cchaine/UMXdbg/README.md

# UMXdbg
A Hardware Debugger board to test UMXbus modules independently
