cchaine/UMXdbg/docs/debug-Power.pdf

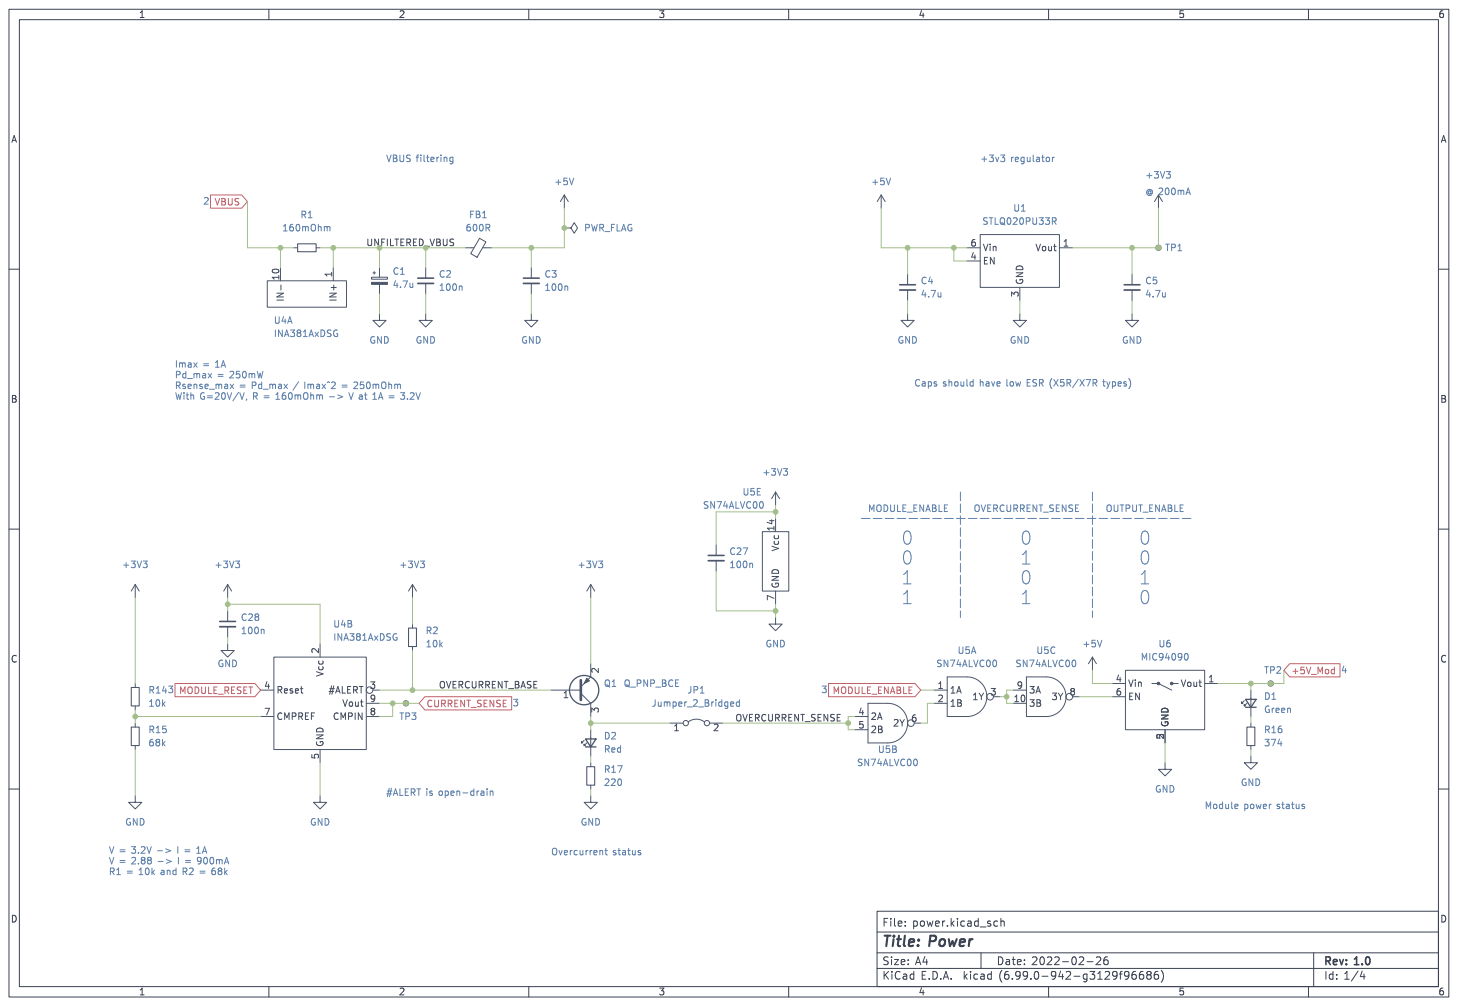
[picture p1: page 1]

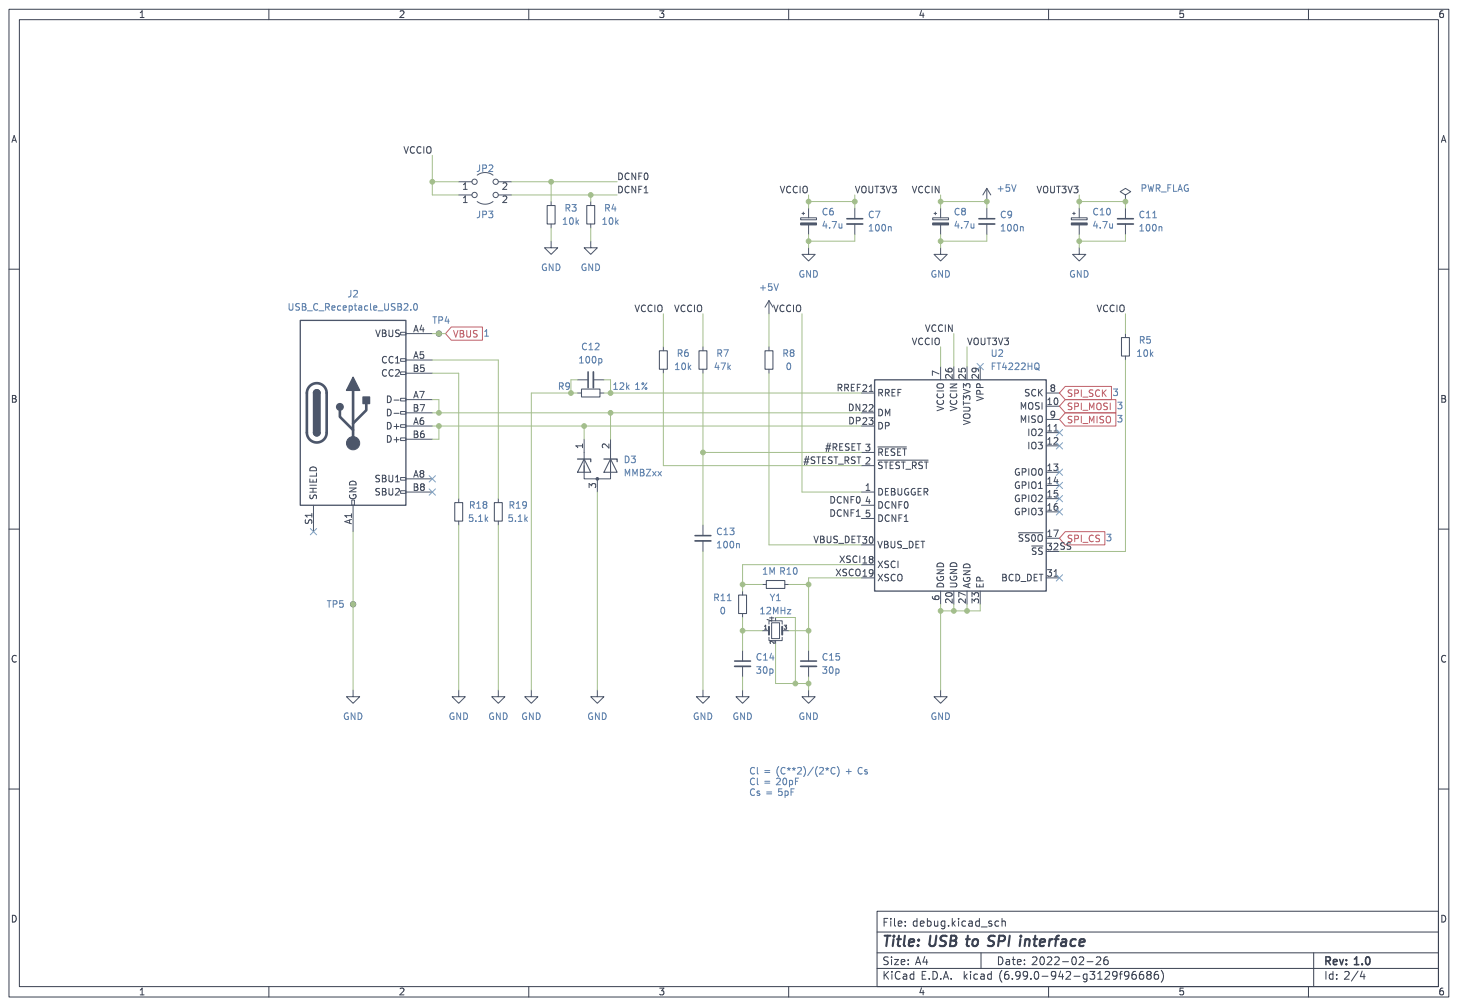
[picture p2: page 2]

File: debug.kicad_sch Bus connector File: schematics/bus.kicad_sch MCU

Id: 2/4 Title: USB to SPI interface

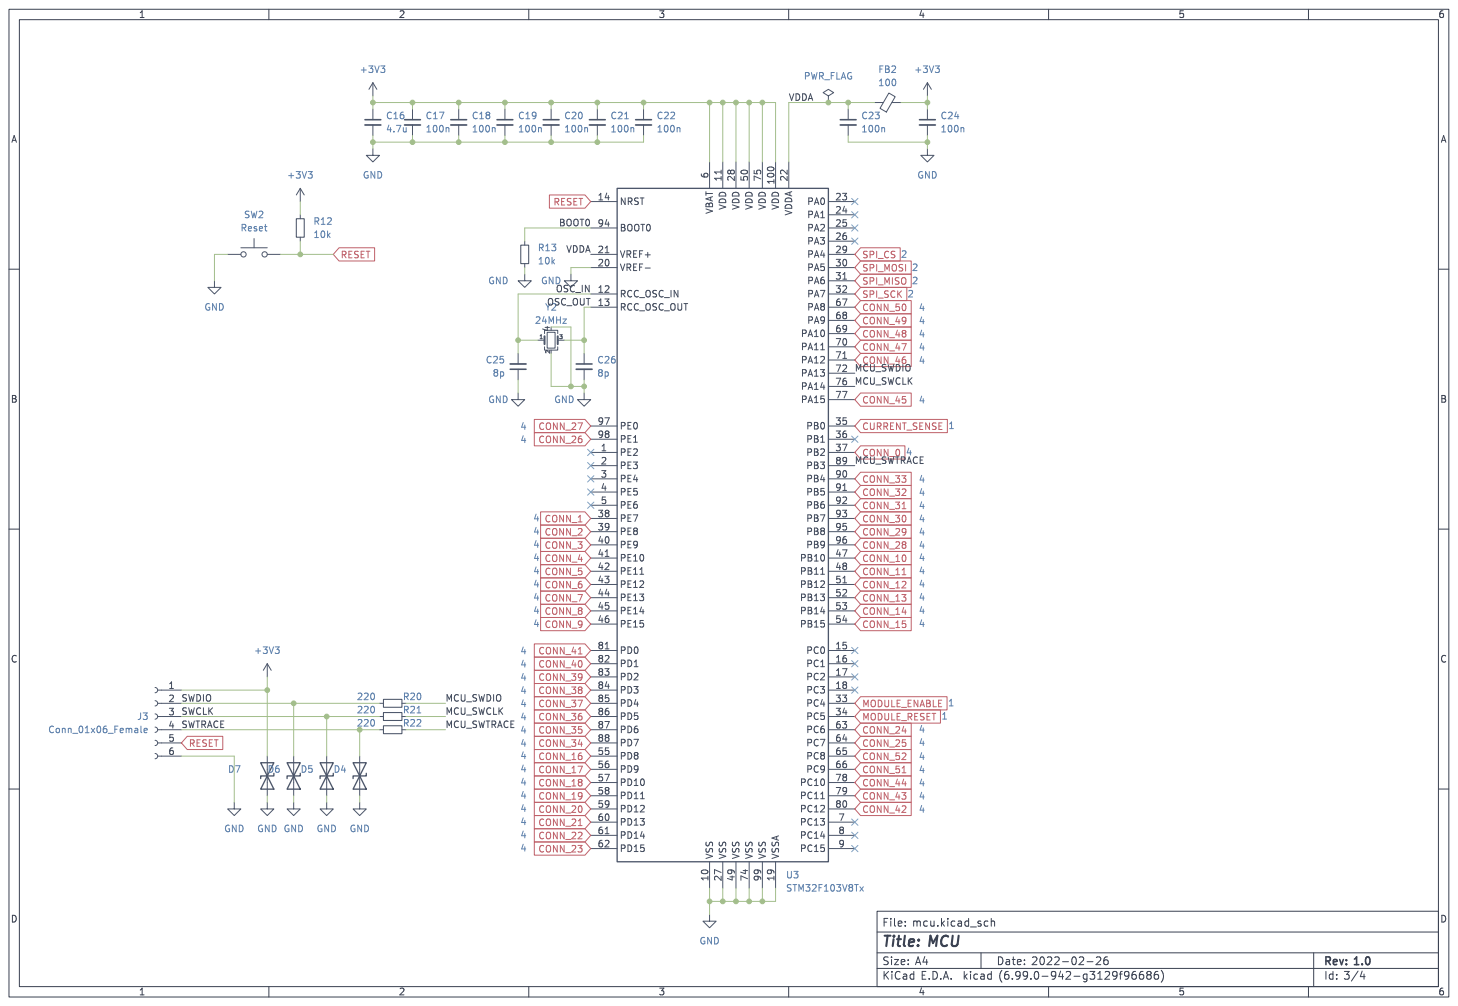
[picture p3: page 3]

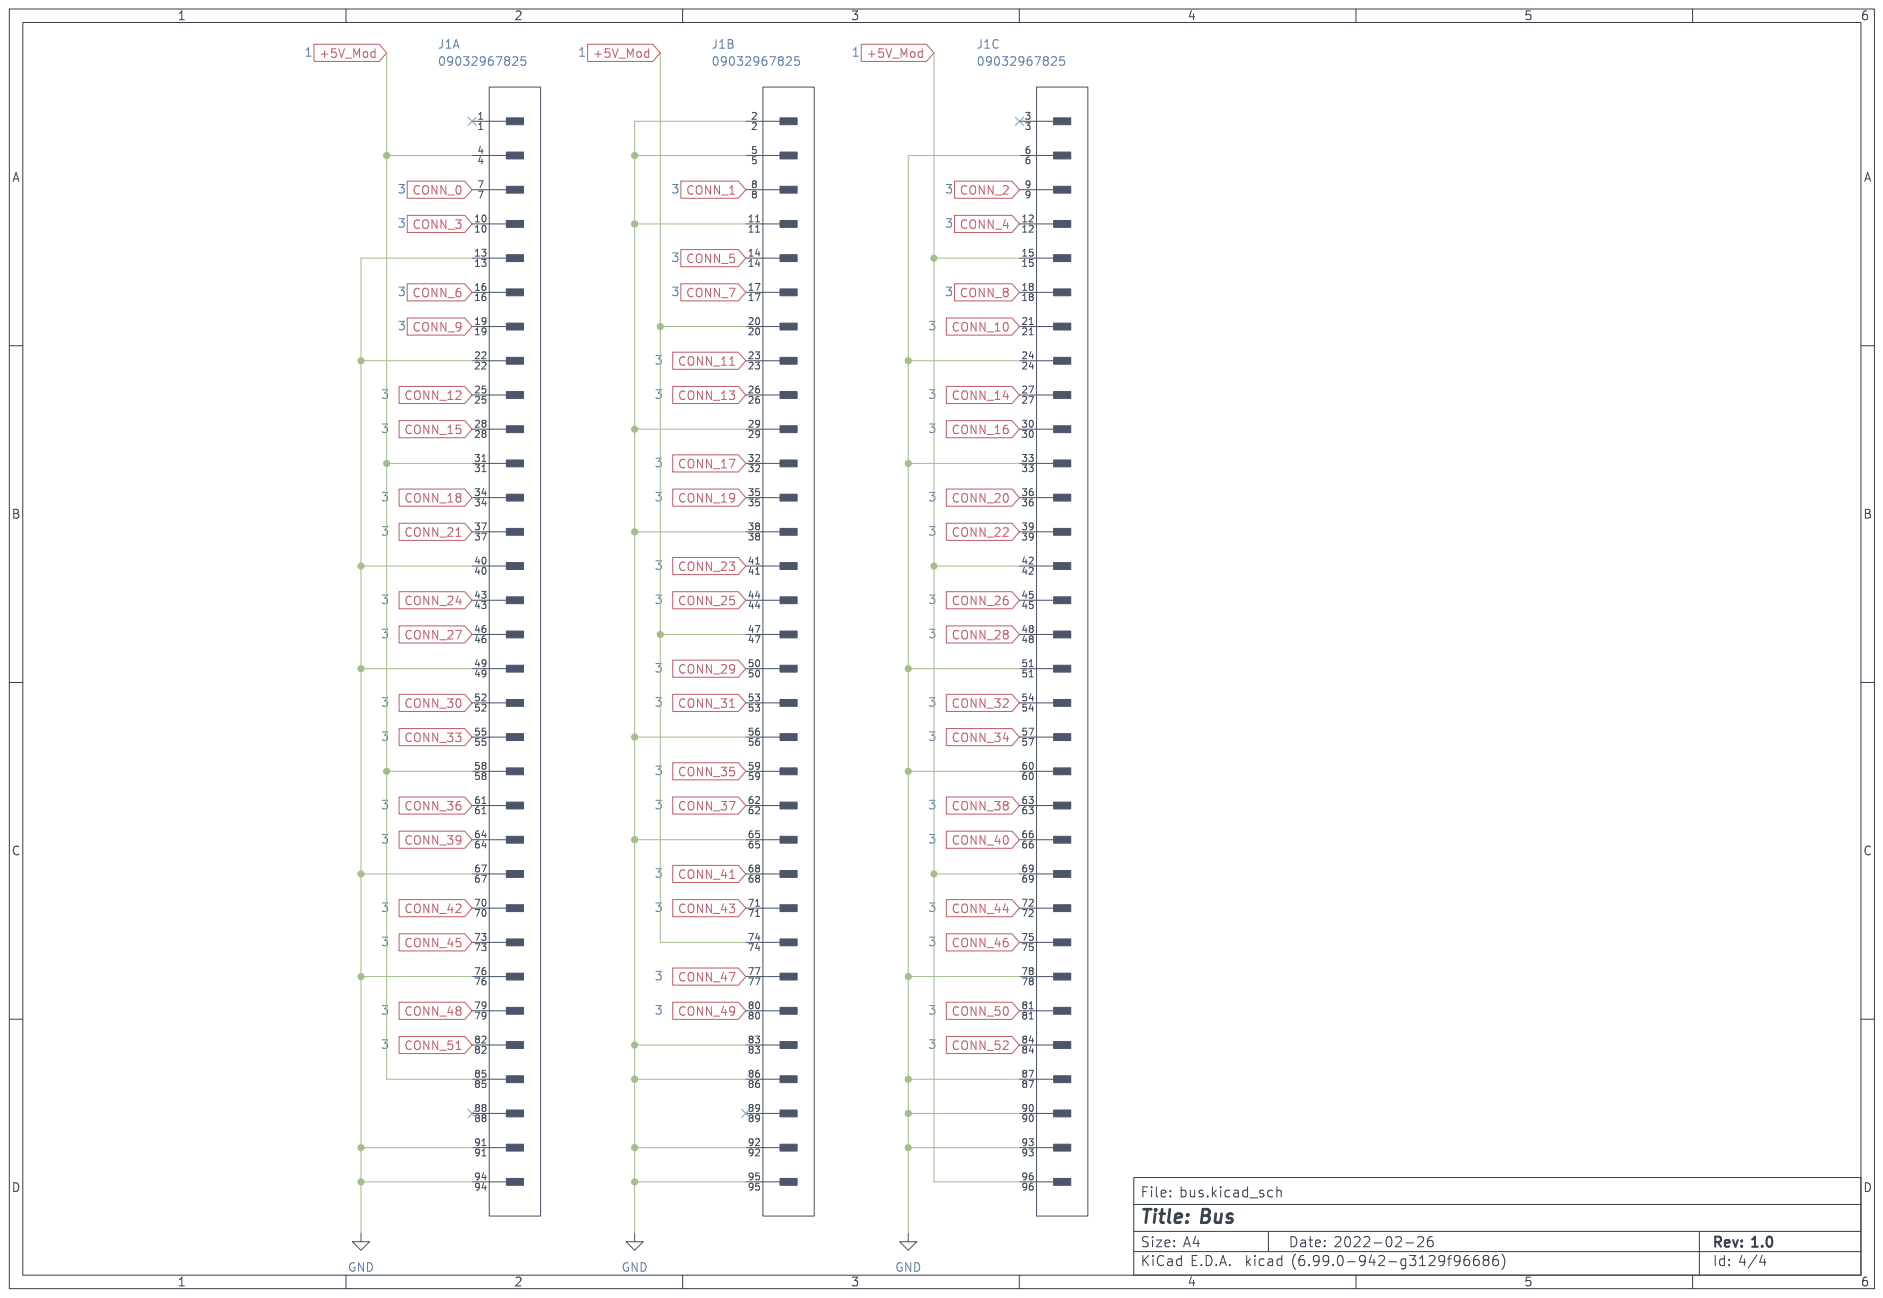
[picture p4: page 4]
