cchaine/UMXdbg/pcb/debug.kicad_pcb

## KiCad design pcb/debug.kicad_pcb (2022-02-19)

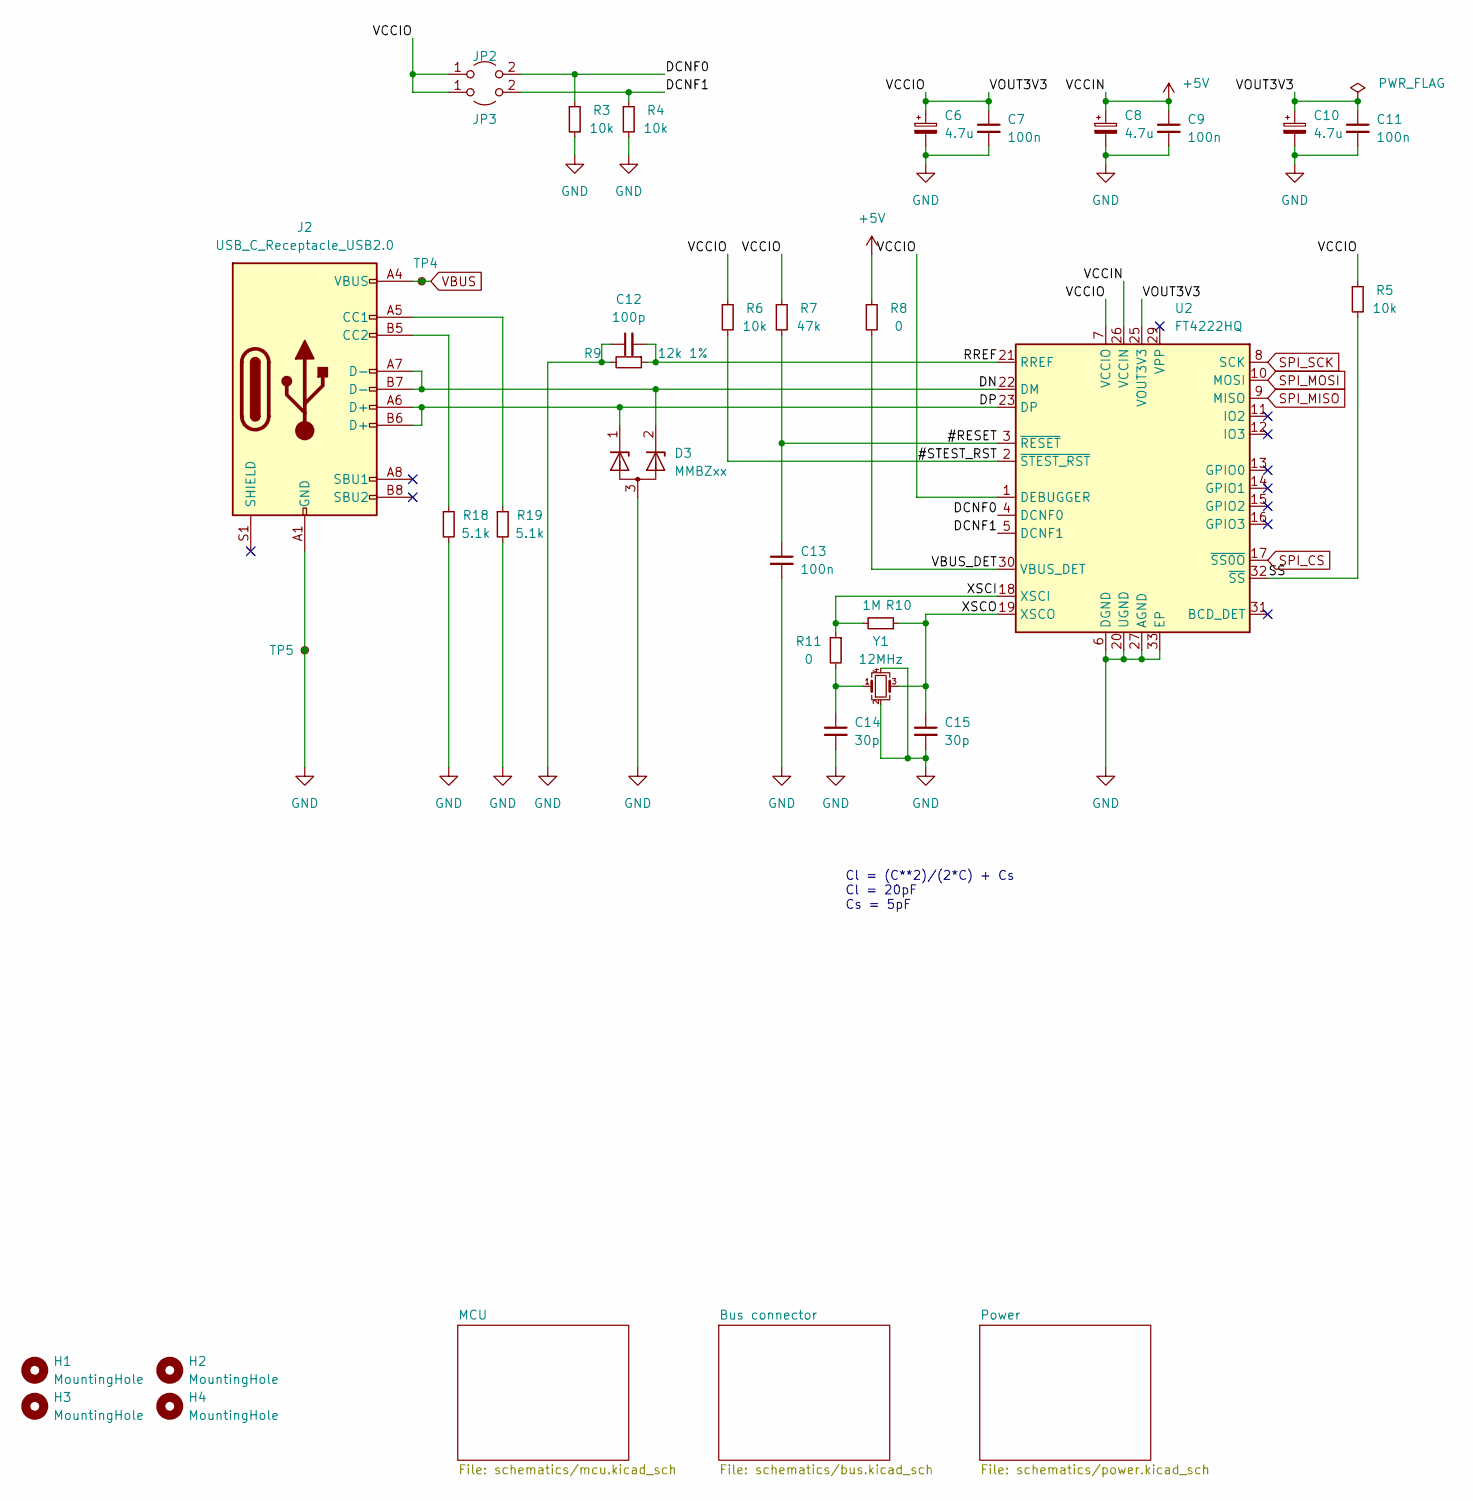
[picture p5: schematic debug.kicad_sch, USB to SPI interface]

Parts:
C6, C8, C10: 4.7u; C_0805_2012Metric; Part Number GRM21BR71C475KE51L
C7, C9, C11, C13: 100n; C_0603_1608Metric; Part Number 885012206095
C12: 100p; C_0603_1608Metric; Part Number 06035A101JAT4A
C14, C15: 30p; C_0603_1608Metric; Part Number C0603C300K1HACTU
D3: MMBZxx; SOT-23; Part Number MMBZ5V6ALFHT116
H1, H2, H3, H4: MountingHole; MountingHole_2.7mm_M2.5
J2: USB_C_Receptacle_USB2.0; GCT_USB4105-GF-A; Part Number USB4105-GF-A
JP2, JP3: Jumper_2_Open; SolderJumper-2_P1.3mm_Open_RoundedPad1.0x1.5mm
R3, R4, R5, R6: 10k; R_0603_1608Metric; Part Number CR0603-FX-1002ELF
R7: 47k; R_0603_1608Metric; Part Number AC0603FR-0747KL
R8, R11: 0; R_0603_1608Metric; Part Number CR0603-J/-000ELF
R9: 12k 1%; R_0603_1608Metric; Part Number RC0603FR-1012KL
R10: 1M; R_0603_1608Metric; Part Number CR0603-FX-1004ELF
R18, R19: 5.1k; R_0603_1608Metric; Part Number CR0603-FX-5101ELF
TP4, TP5: TestPoint_Small; TestPoint_Loop_D2.54mm_Drill1.5mm_Beaded
U2: FT4222HQ; VQFN-32-1EP_5x5mm_P0.5mm_EP3.1x3.1mm; Part Number FT4222HQ-D-R
Y1: 12MHz; XTAL_ECS-120-18-33-JGN-TR; Part Number ECS-120-18-33-JGN-TR3

Connections:
+5V: C8.1, C9.1, R8.1, U2.26 (VCCIN); also elsewhere on the board
/#RESET: C13.1, R7.2, U2.3 (~RESET)
/#STEST_RST: R6.2, U2.2 (~STEST_RST)
/DCNF0: JP2.2 (B), R3.1, U2.4 (DCNF0)
/DCNF1: JP3.2 (B), R4.1, U2.5 (DCNF1)
/DN: D3.2 (K), J2.A7 (D-), J2.B7 (D-), U2.22 (DM)
/DP: D3.1 (K), J2.A6 (D+), J2.B6 (D+), U2.23 (DP)
/RREF: C12.2, R9.1, U2.21 (RREF)
/SS: R5.2, U2.32 (~SS)
/VBUS_DET: R8.2, U2.30 (VBUS_DET)
/VCCIO: C6.1, C7.1, C10.1, C11.1, JP2.1 (A), JP3.1 (A), R5.1, R6.1, R7.1, U2.1 (DEBUGGER), U2.7 (VCCIO), U2.25 (VOUT3V3)
/XSCI: R10.2, R11.1, U2.18 (XSCI)
/XSCO: C15.1, R10.1, U2.19 (XSCO), Y1.3
GND: C6.2, C7.2, C8.2, C9.2, C10.2, C11.2, C12.1, C13.2, C14.2, C15.2, D3.3 (A), J2.A1 (GND), J2.A12 (GND), J2.B1 (GND), J2.B12 (GND), R3.2, R4.2, R9.2, R18.2, R19.2, TP5.1, U2.6 (DGND), U2.20 (UGND), U2.24 (UGND), U2.27 (AGND), U2.28 (DGND), U2.33 (EP), Y1.2, Y1.4; also elsewhere on the board
unnamed: C14.1, R11.2, Y1.1
unnamed: J2.A5 (CC1), R19.1
unnamed: J2.B5 (CC2), R18.1
SPI_CS: U2.17 (~SS0O); also elsewhere on the board
SPI_MISO: U2.9 (MISO); also elsewhere on the board
SPI_MOSI: U2.10 (MOSI); also elsewhere on the board
SPI_SCK: U2.8 (SCK); also elsewhere on the board
VBUS: J2.A4 (VBUS), J2.A9 (VBUS), J2.B4 (VBUS), J2.B9 (VBUS), TP4.1; also elsewhere on the board

Notes on the sheet:
Cl = (C**2)/(2*C) + Cs Cl = 20pF Cs = 5pF

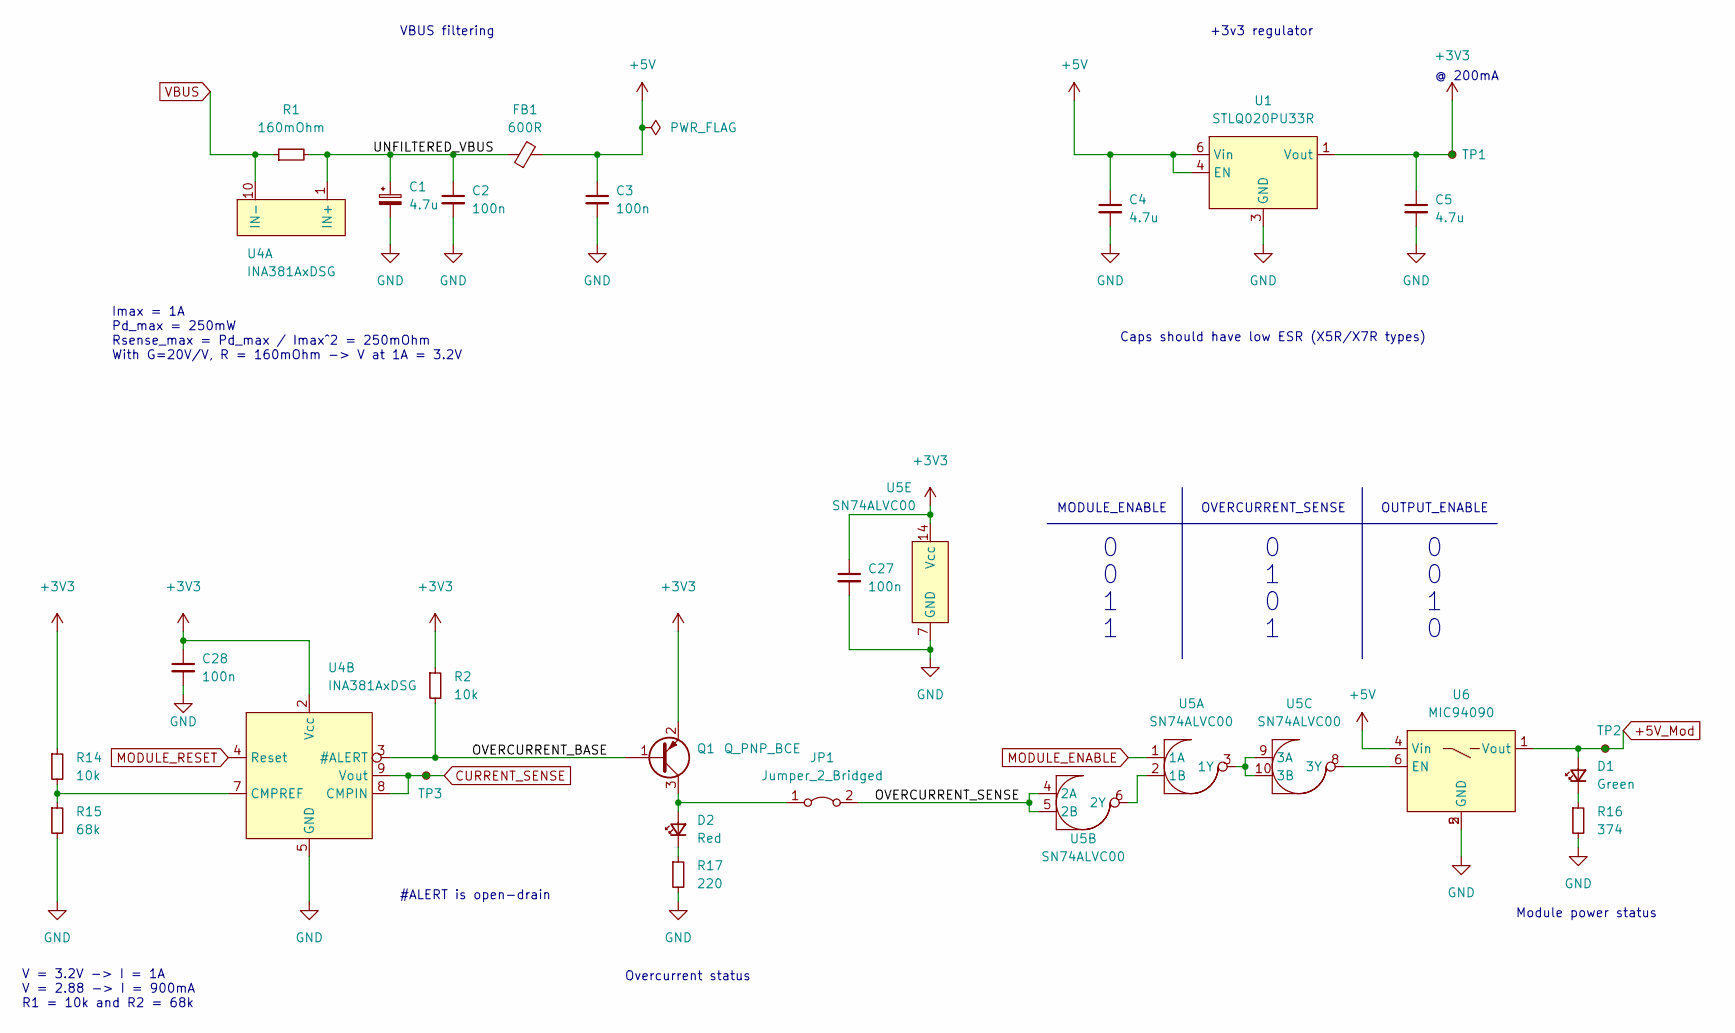
[picture p6: schematic power.kicad_sch]

Parts:
C1, C4, C5: 4.7u; C_0805_2012Metric; Part Number GRM21BR71C475KE51L
C2, C3, C27, C28: 100n; C_0603_1608Metric; Part Number 885012206095
D1: Green; LED_1206_3216Metric; Part Number 156120VS75300
D2: Red; LED_1206_3216Metric; Part Number 156120RS75300
FB1: 600R; L_1206_3216Metric; Part Number MH3261-601Y
JP1: Jumper_2_Bridged; SolderJumper-2_P1.3mm_Bridged_RoundedPad1.0x1.5mm
Q1: Q_PNP_BCE; SOT-23; Part Number BC857,215
R1: 160mOhm; R_0805_2012Metric; Part Number RL1220S-R16-F
R2, R14: 10k; R_0603_1608Metric; Part Number CR0603-FX-1002ELF
R15: 68k; R_0603_1608Metric; Part Number CR0603-FX-6802ELF
R16: 374; R_0603_1608Metric; Part Number CR0603-FX-3740ELF
R17: 220; R_0603_1608Metric; Part Number RC0603FR-07220RL
TP1, TP2, TP3: TestPoint_Small; TestPoint_Loop_D2.54mm_Drill1.5mm_Beaded
U1: STLQ020PU33R; DFN-6-1EP_2x2mm_P0.5mm_EP0.6x1.37mm; Part Number STLQ020PU33R
U4: INA381AxDSG; VSSOP-10_3x3mm_P0.5mm; Part Number INA381A1IDGSR
U5: SN74ALVC00; TSSOP-14_4.4x5mm_P0.65mm; Part Number SN74ALVC00PWR
U6: MIC94090; SOT-363_SC-70-6; Part Number MIC94090YC6-TR

Connections:
+3V3: C5.1, C27.1, C28.1, Q1.2 (E), R2.1, R14.1, TP1.1, U1.1 (Vout), U4.2 (Vcc), U5.14 (Vcc); also elsewhere on the board
+5V: C3.1, C4.1, FB1.2, U1.4 (EN), U1.6 (Vin), U6.4 (Vin); also elsewhere on the board
+5V_Mod: D1.2 (A), TP2.1, U6.1 (Vout); also elsewhere on the board
/Power/OVERCURRENT_BASE: Q1.1 (B), R2.2, U4.3 (#ALERT)
/Power/OVERCURRENT_SENSE: JP1.2 (B), U5.4 (2A), U5.5 (2B)
/Power/UNFILTERED_VBUS: C1.1, C2.1, FB1.1, R1.2, U4.1 (IN+)
CURRENT_SENSE: TP3.1, U4.8 (CMPIN), U4.9 (Vout); also elsewhere on the board
GND: C1.2, C2.2, C3.2, C4.2, C5.2, C27.2, C28.2, R15.2, R16.2, R17.2, U1.3 (GND), U4.5 (GND), U5.7 (GND), U6.2 (GND), U6.5 (GND); also elsewhere on the board
MODULE_ENABLE: U5.1 (1A); also elsewhere on the board
MODULE_RESET: U4.4 (Reset); also elsewhere on the board
unnamed: D1.1 (K), R16.1
unnamed: D2.2 (A), JP1.1 (A), Q1.3 (C)
unnamed: D2.1 (K), R17.1
unnamed: R14.2, R15.1, U4.7 (CMPREF)
unnamed: U5.2 (1B), U5.6 (2Y)
unnamed: U5.3 (1Y), U5.9 (3A), U5.10 (3B)
unnamed: U5.8 (3Y), U6.6 (EN)
VBUS: R1.1, U4.10 (IN-); also elsewhere on the board

Notes on the sheet:
OVERCURRENT_SENSE
Module power status
Overcurrent status
@ 200mA
VBUS filtering
V = 3.2V -> I = 1A V = 2.88 -> I = 900mA R1 = 10k and R2 = 68k
Imax = 1A Pd_max = 250mW Rsense_max = Pd_max / Imax^2 = 250mOhm With G=20V/V, R = 160mOhm -> V at 1A = 3.2V
+3v3 regulator
#ALERT is open-drain
OUTPUT_ENABLE
Caps should have low ESR (X5R/X7R types)
MODULE_ENABLE

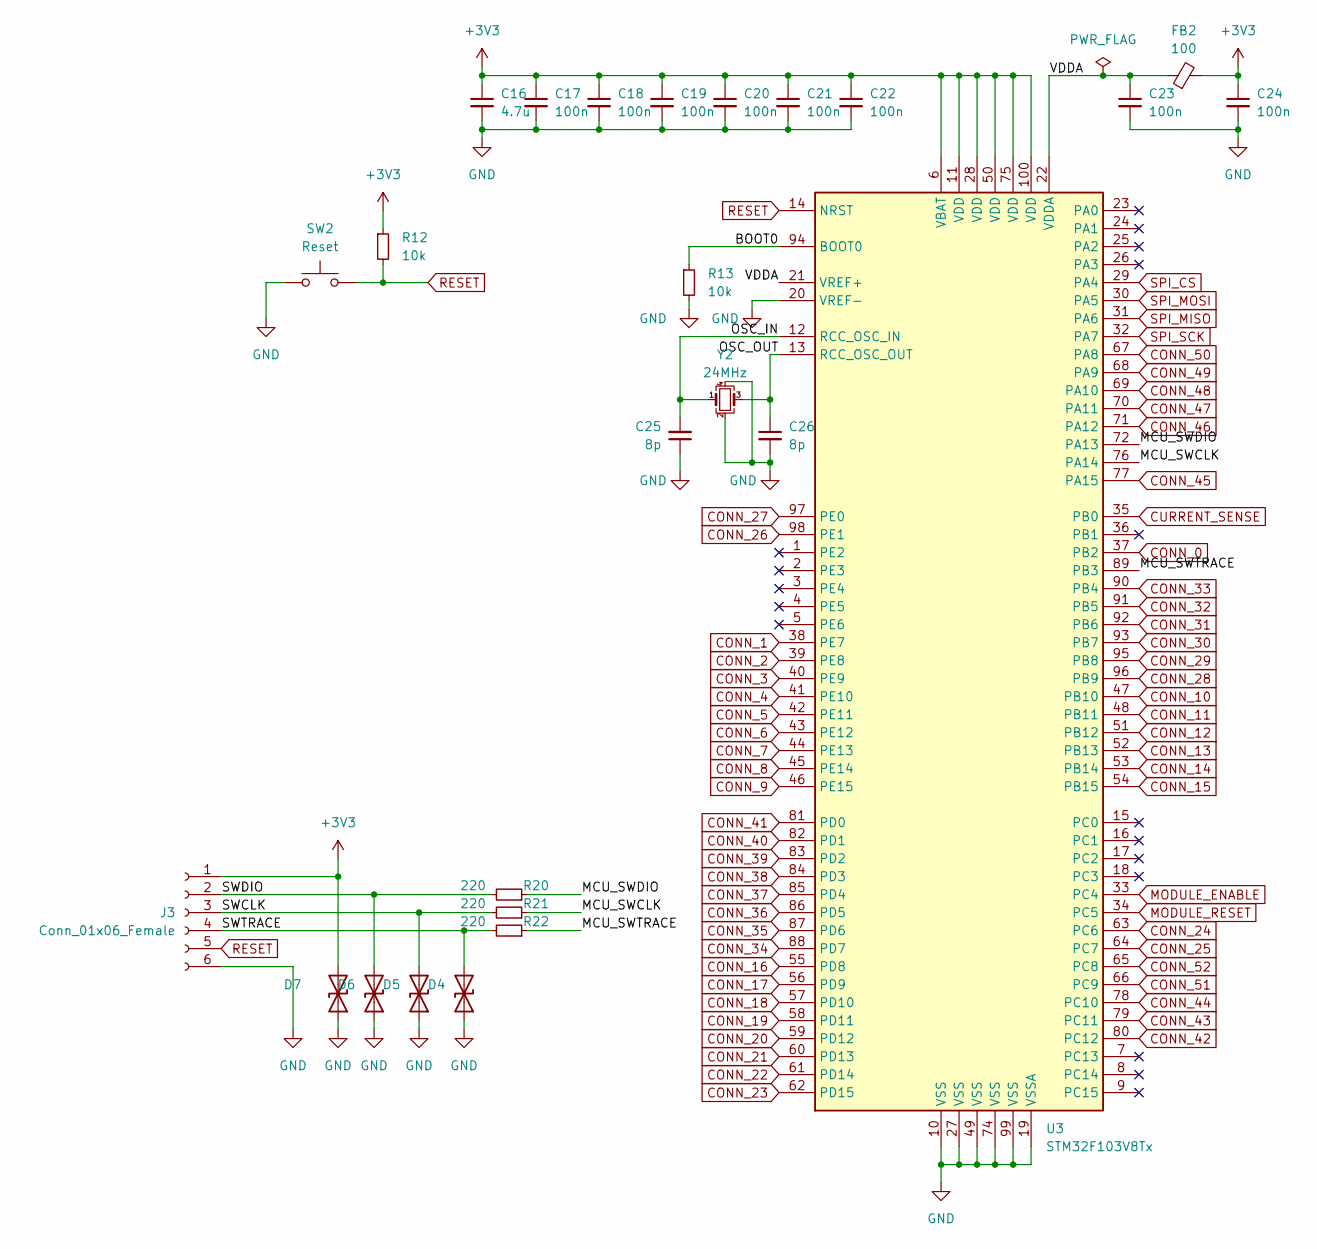
[picture p7: schematic mcu.kicad_sch]

Parts:
C16: 4.7u; C_0805_2012Metric; Part Number GRM21BR71C475KE51L
C17, C18, C19, C20, C21, C22, C23, C24: 100n; C_0603_1608Metric; Part Number 885012206095
C25, C26: 8p; C_0603_1608Metric; Part Number C1608C0G1H080D080AA
D4, D5, D6, D7: D_TVS; TVS_ESD9D5.0ST5G; Part Number DF2S10FS,L3M
FB2: 100; L_0805_2012Metric; Part Number MG2029-101Y
J3: Conn_01x06_Female; PinHeader_1x06_P1.27mm_Vertical
R12, R13: 10k; R_0603_1608Metric; Part Number CR0603-FX-1002ELF
R20, R21, R22: 220; R_0603_1608Metric; Part Number RC0603FR-07220RL
SW2: Reset; Panasonic_EVQPUJ_EVQPUA
U3: STM32F103V8Tx; LQFP-100_14x14mm_P0.5mm; Part Number STM32F103V8Tx
Y2: 24MHz; Crystal_SMD_SeikoEpson_TSX3225-4Pin_3.2x2.5mm; Part Number 732-22524MF15X-AC6

Connections:
+3V3: C16.1, C17.1, C18.1, C19.1, C20.1, C21.1, C22.1, C24.1, D7.2 (A2), FB2.2, J3.1, R12.1, U3.6 (VBAT), U3.11 (VDD), U3.28 (VDD), U3.50 (VDD), U3.75 (VDD), U3.100 (VDD); also elsewhere on the board
/MCU/BOOT0: R13.1, U3.94 (BOOT0)
/MCU/MCU_SWCLK: R21.1, U3.76 (PA14)
/MCU/MCU_SWDIO: R20.1, U3.72 (PA13)
/MCU/MCU_SWTRACE: R22.1, U3.89 (PB3)
/MCU/OSC_IN: C25.2, U3.12 (RCC_OSC_IN), Y2.1
/MCU/OSC_OUT: C26.1, U3.13 (RCC_OSC_OUT), Y2.3
/MCU/SWCLK: D5.2 (A2), J3.3, R21.2
/MCU/SWDIO: D6.2 (A2), J3.2, R20.2
/MCU/SWTRACE: D4.2 (A2), J3.4, R22.2
/MCU/VDDA: C23.1, FB2.1, U3.21 (VREF+), U3.22 (VDDA)
CONN_0: U3.37 (PB2); also elsewhere on the board
CONN_1: U3.38 (PE7); also elsewhere on the board
CONN_2: U3.39 (PE8); also elsewhere on the board
CONN_3: U3.40 (PE9); also elsewhere on the board
CONN_4: U3.41 (PE10); also elsewhere on the board
CONN_5: U3.42 (PE11); also elsewhere on the board
CONN_6: U3.43 (PE12); also elsewhere on the board
CONN_7: U3.44 (PE13); also elsewhere on the board
CONN_8: U3.45 (PE14); also elsewhere on the board
CONN_9: U3.46 (PE15); also elsewhere on the board
CONN_10: U3.47 (PB10); also elsewhere on the board
CONN_11: U3.48 (PB11); also elsewhere on the board
CONN_12: U3.51 (PB12); also elsewhere on the board
CONN_13: U3.52 (PB13); also elsewhere on the board
CONN_14: U3.53 (PB14); also elsewhere on the board
CONN_15: U3.54 (PB15); also elsewhere on the board
CONN_16: U3.55 (PD8); also elsewhere on the board
CONN_17: U3.56 (PD9); also elsewhere on the board
CONN_18: U3.57 (PD10); also elsewhere on the board
CONN_19: U3.58 (PD11); also elsewhere on the board
CONN_20: U3.59 (PD12); also elsewhere on the board
CONN_21: U3.60 (PD13); also elsewhere on the board
CONN_22: U3.61 (PD14); also elsewhere on the board
CONN_23: U3.62 (PD15); also elsewhere on the board
CONN_24: U3.63 (PC6); also elsewhere on the board
CONN_25: U3.64 (PC7); also elsewhere on the board
CONN_26: U3.98 (PE1); also elsewhere on the board
CONN_27: U3.97 (PE0); also elsewhere on the board
CONN_28: U3.96 (PB9); also elsewhere on the board
CONN_29: U3.95 (PB8); also elsewhere on the board
CONN_30: U3.93 (PB7); also elsewhere on the board
CONN_31: U3.92 (PB6); also elsewhere on the board
CONN_32: U3.91 (PB5); also elsewhere on the board
CONN_33: U3.90 (PB4); also elsewhere on the board
CONN_34: U3.88 (PD7); also elsewhere on the board
CONN_35: U3.87 (PD6); also elsewhere on the board
CONN_36: U3.86 (PD5); also elsewhere on the board
CONN_37: U3.85 (PD4); also elsewhere on the board
CONN_38: U3.84 (PD3); also elsewhere on the board
CONN_39: U3.83 (PD2); also elsewhere on the board
CONN_40: U3.82 (PD1); also elsewhere on the board
CONN_41: U3.81 (PD0); also elsewhere on the board
CONN_42: U3.80 (PC12); also elsewhere on the board
CONN_43: U3.79 (PC11); also elsewhere on the board
CONN_44: U3.78 (PC10); also elsewhere on the board
CONN_45: U3.77 (PA15); also elsewhere on the board
CONN_46: U3.71 (PA12); also elsewhere on the board
CONN_47: U3.70 (PA11); also elsewhere on the board
CONN_48: U3.69 (PA10); also elsewhere on the board
CONN_49: U3.68 (PA9); also elsewhere on the board
CONN_50: U3.67 (PA8); also elsewhere on the board
CONN_51: U3.66 (PC9); also elsewhere on the board
CONN_52: U3.65 (PC8); also elsewhere on the board
CURRENT_SENSE: U3.35 (PB0); also elsewhere on the board
GND: C16.2, C17.2, C18.2, C19.2, C20.2, C21.2, C22.2, C23.2, C24.2, C25.1, C26.2, D4.1 (A1), D5.1 (A1), D6.1 (A1), D7.1 (A1), J3.6, R13.2, SW2.1, U3.10 (VSS), U3.19 (VSSA), U3.20 (VREF-), U3.27 (VSS), U3.49 (VSS), U3.74 (VSS), U3.99 (VSS), Y2.2, Y2.4; also elsewhere on the board
MODULE_ENABLE: U3.33 (PC4); also elsewhere on the board
MODULE_RESET: U3.34 (PC5); also elsewhere on the board
RESET: J3.5, R12.2, SW2.2, U3.14 (NRST)
SPI_CS: U3.29 (PA4); also elsewhere on the board
SPI_MISO: U3.31 (PA6); also elsewhere on the board
SPI_MOSI: U3.30 (PA5); also elsewhere on the board
SPI_SCK: U3.32 (PA7); also elsewhere on the board

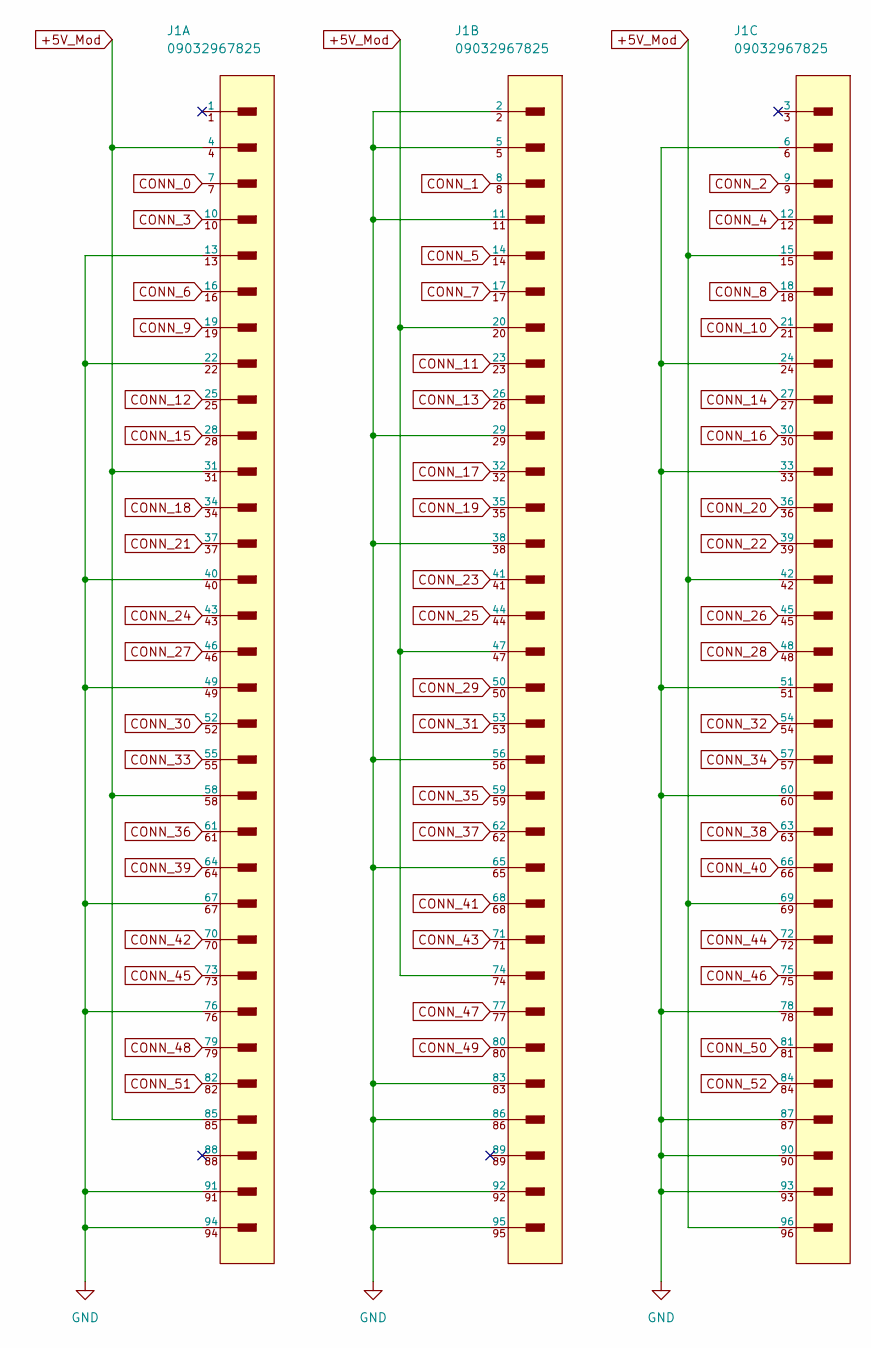
[picture p8: schematic bus.kicad_sch]

Parts:
J1: 09032967825; Harting-09031966921-0-0-0; current rating 2A; mouser part number 617-09-03-196-6921; digikey description DIN-SIGNAL C096MS-3,0C1-2

Connections:
+5V_Mod: J1.4, J1.15, J1.20, J1.31, J1.42, J1.47, J1.58, J1.69, J1.74, J1.85, J1.96; also elsewhere on the board
CONN_0: J1.7; also elsewhere on the board
CONN_1: J1.8; also elsewhere on the board
CONN_2: J1.9; also elsewhere on the board
CONN_3: J1.10; also elsewhere on the board
CONN_4: J1.12; also elsewhere on the board
CONN_5: J1.14; also elsewhere on the board
CONN_6: J1.16; also elsewhere on the board
CONN_7: J1.17; also elsewhere on the board
CONN_8: J1.18; also elsewhere on the board
CONN_9: J1.19; also elsewhere on the board
CONN_10: J1.21; also elsewhere on the board
CONN_11: J1.23; also elsewhere on the board
CONN_12: J1.25; also elsewhere on the board
CONN_13: J1.26; also elsewhere on the board
CONN_14: J1.27; also elsewhere on the board
CONN_15: J1.28; also elsewhere on the board
CONN_16: J1.30; also elsewhere on the board
CONN_17: J1.32; also elsewhere on the board
CONN_18: J1.34; also elsewhere on the board
CONN_19: J1.35; also elsewhere on the board
CONN_20: J1.36; also elsewhere on the board
CONN_21: J1.37; also elsewhere on the board
CONN_22: J1.39; also elsewhere on the board
CONN_23: J1.41; also elsewhere on the board
CONN_24: J1.43; also elsewhere on the board
CONN_25: J1.44; also elsewhere on the board
CONN_26: J1.45; also elsewhere on the board
CONN_27: J1.46; also elsewhere on the board
CONN_28: J1.48; also elsewhere on the board
CONN_29: J1.50; also elsewhere on the board
CONN_30: J1.52; also elsewhere on the board
CONN_31: J1.53; also elsewhere on the board
CONN_32: J1.54; also elsewhere on the board
CONN_33: J1.55; also elsewhere on the board
CONN_34: J1.57; also elsewhere on the board
CONN_35: J1.59; also elsewhere on the board
CONN_36: J1.61; also elsewhere on the board
CONN_37: J1.62; also elsewhere on the board
CONN_38: J1.63; also elsewhere on the board
CONN_39: J1.64; also elsewhere on the board
CONN_40: J1.66; also elsewhere on the board
CONN_41: J1.68; also elsewhere on the board
CONN_42: J1.70; also elsewhere on the board
CONN_43: J1.71; also elsewhere on the board
CONN_44: J1.72; also elsewhere on the board
CONN_45: J1.73; also elsewhere on the board
CONN_46: J1.75; also elsewhere on the board
CONN_47: J1.77; also elsewhere on the board
CONN_48: J1.79; also elsewhere on the board
CONN_49: J1.80; also elsewhere on the board
CONN_50: J1.81; also elsewhere on the board
CONN_51: J1.82; also elsewhere on the board
CONN_52: J1.84; also elsewhere on the board
GND: J1.2, J1.5, J1.6, J1.11, J1.13, J1.22, J1.24, J1.29, J1.33, J1.38, J1.40, J1.49, J1.51, J1.56, J1.60, J1.65, J1.67, J1.76, J1.78, J1.83, J1.86, J1.87, J1.90, J1.91, J1.92, J1.93, J1.94, J1.95; also elsewhere on the board

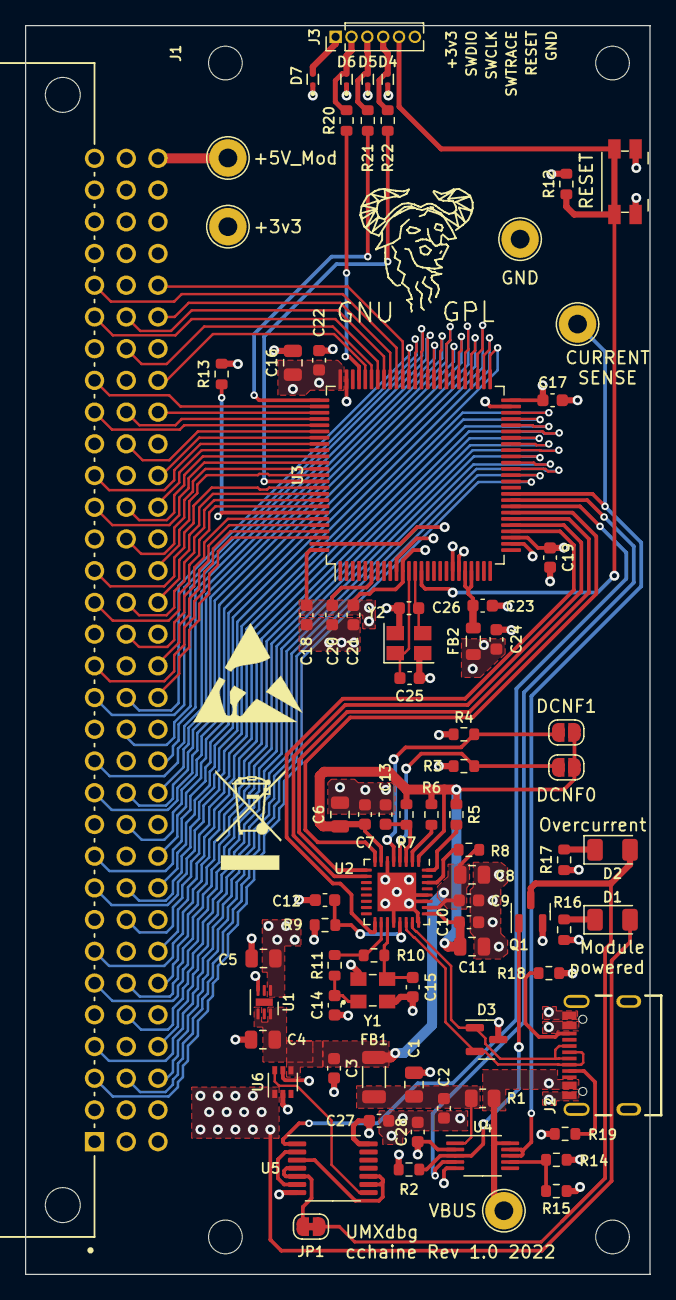
[picture p9: board debug.kicad_pcb from above]

Board: 4 copper layers, 50.0 x 100.0 mm, 84 parts (0 on the bottom side), 101 nets.
