cchaine/UMXdbg/(commit log)

2022-01-21 add main components
    [bus.kicad_sch, debug.kicad_pcb, debug.kicad_sch, mcu.kicad_sch, power.kicad_sch]
2022-01-21 add power schematics
    [bus.kicad_sch, debug.kicad_sch, power.kicad_sch]
2022-01-21 start the schematics for the usb to spi interface
    [debug.kicad_sch, power.kicad_sch]
2022-01-24 start choosing components, need to add overcurren t protection
    [bus.kicad_sch, debug.kicad_sch, mcu.kicad_sch, power.kicad_sch]
2022-01-26 add current sensing
    [bus.kicad_sch, debug.kicad_sch, mcu.kicad_sch, power.kicad_sch]
2022-01-26 add power switch simulation
    [power-switch.sch]
2022-01-31 finish the schematic
    [bus.kicad_sch, debug.kicad_sch, mcu.kicad_sch, power.kicad_sch]
2022-01-31 add components to the pcb
    [bus.kicad_sch, debug.kicad_pcb, debug.kicad_sch, power-switch.sch]
2022-01-31 start placing components
    [bus.kicad_sch, debug.kicad_pcb, debug.kicad_sch]
2022-02-01 moved components
    [debug.kicad_pcb]
2022-02-01 move components
    [debug.kicad_pcb]
2022-02-04 finished placing components
    [debug.kicad_pcb, debug.kicad_sch]
2022-02-04 route the power supply
    [debug.kicad_pcb, debug.kicad_sch]
2022-02-05 add missing 3d models
    [debug.kicad_pcb]
2022-02-06 route more components
    [bus.kicad_sch, debug.kicad_pcb, debug.kicad_sch]
2022-02-08 add SWD
    [debug.kicad_pcb, debug.kicad_sch, mcu.kicad_sch]
2022-02-08 add bus traces
    [debug.kicad_pcb, mcu.kicad_sch]
2022-02-11 add traces to the internal bus
    [debug.kicad_pcb]
2022-02-14 route more data traces
    [mcu.kicad_sch]
2022-02-15 finished routing the bus traces
    [bus.kicad_sch, debug.kicad_pcb, debug.kicad_sch, mcu.kicad_sch, power.kicad_sch]
2022-02-16 add power vias
    [debug.kicad_pcb]
2022-02-18 routed everything, need to add TP
    [debug.kicad_pcb]
2022-02-19 finished pcb
    [debug.kicad_pcb, debug.kicad_sch, mcu.kicad_sch, power.kicad_sch]
2022-05-28 finished the board
    [bus.kicad_sch, debug.kicad_sch, mcu.kicad_sch, power.kicad_sch]
